abluenautilus/Patch_SM_Breadboard_Adapter/BOM.xlsx

Quantity | IPN | MPN | Description | Identifiers | Link
1 | 10 PIN SHROUDED BOX HEADER | HDR61201021621 | Eurorack power header, shrouded | Power | https://synthcube.com/cart/eurorack-ribbon-power-cables
4 | CONN HDR 10POS 0.1 GOLD PCB | 732-2861-ND | 2.54mm pitch, 2x5, vertical female header | ES_DAISY_PATCH_SM_REV1 | https://www.digikey.com/en/products/detail/würth-elektronik/61301021821/2508630
4 | CONN HEADER VERT 10POS 2.54MM | 732-2670-ND | 2.54mm pitch, 1x10, vertical male header | A1, B1, C1, D1 | https://www.digikey.com/en/products/detail/würth-elektronik/61301011121/2508439
