abluenautilus/Patch_SM_Breadboard_Adapter/(commit log)

2024-03-31 initial upload
    [Patch_SM_Breadboard_Adapter-B_Cu.gbr, Patch_SM_Breadboard_Adapter-B_Mask.gbr, Patch_SM_Breadboard_Adapter-B_Paste.gbr, Patch_SM_Breadboard_Adapter-B_Silkscreen.gbr, Patch_SM_Breadboard_Adapter-Edge_Cuts.gbr, Patch_SM_Breadboard_Adapter-F_Cu.gbr, Patch_SM_Breadboard_Adapter-F_Mask.gbr, Patch_SM_Breadboard_Adapter-F_Paste.gbr]
2024-10-20 fixed pins A8 and A9 label
    [Patch_SM_Breadboard_Adapter.kicad_pcb]
